tcfh2003/Proiect_CEF2/P1_2024_434C_Fratu-Halunga_Theodor-Corneliu_GST_N22_LTspice/Layout/Layout.jpg

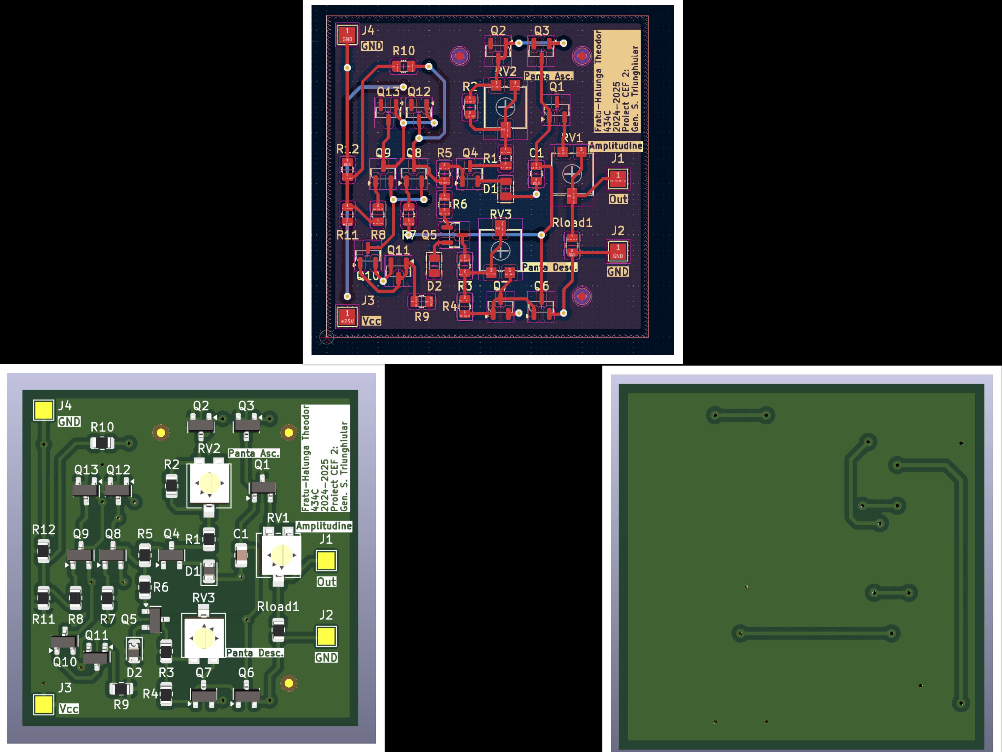
P1_2024_434C_Fratu-Halunga_Theodor-Corneliu_GST_N22_LTspice/Layout/Layout.jpg
