tcfh2003/Proiect_CEF2/P1_2024_434C_Fratu-Halunga_Theodor-Corneliu_GST_N22_LTspice/Schematics/Schematic_ProiectCEF2_KiCAD.jpg

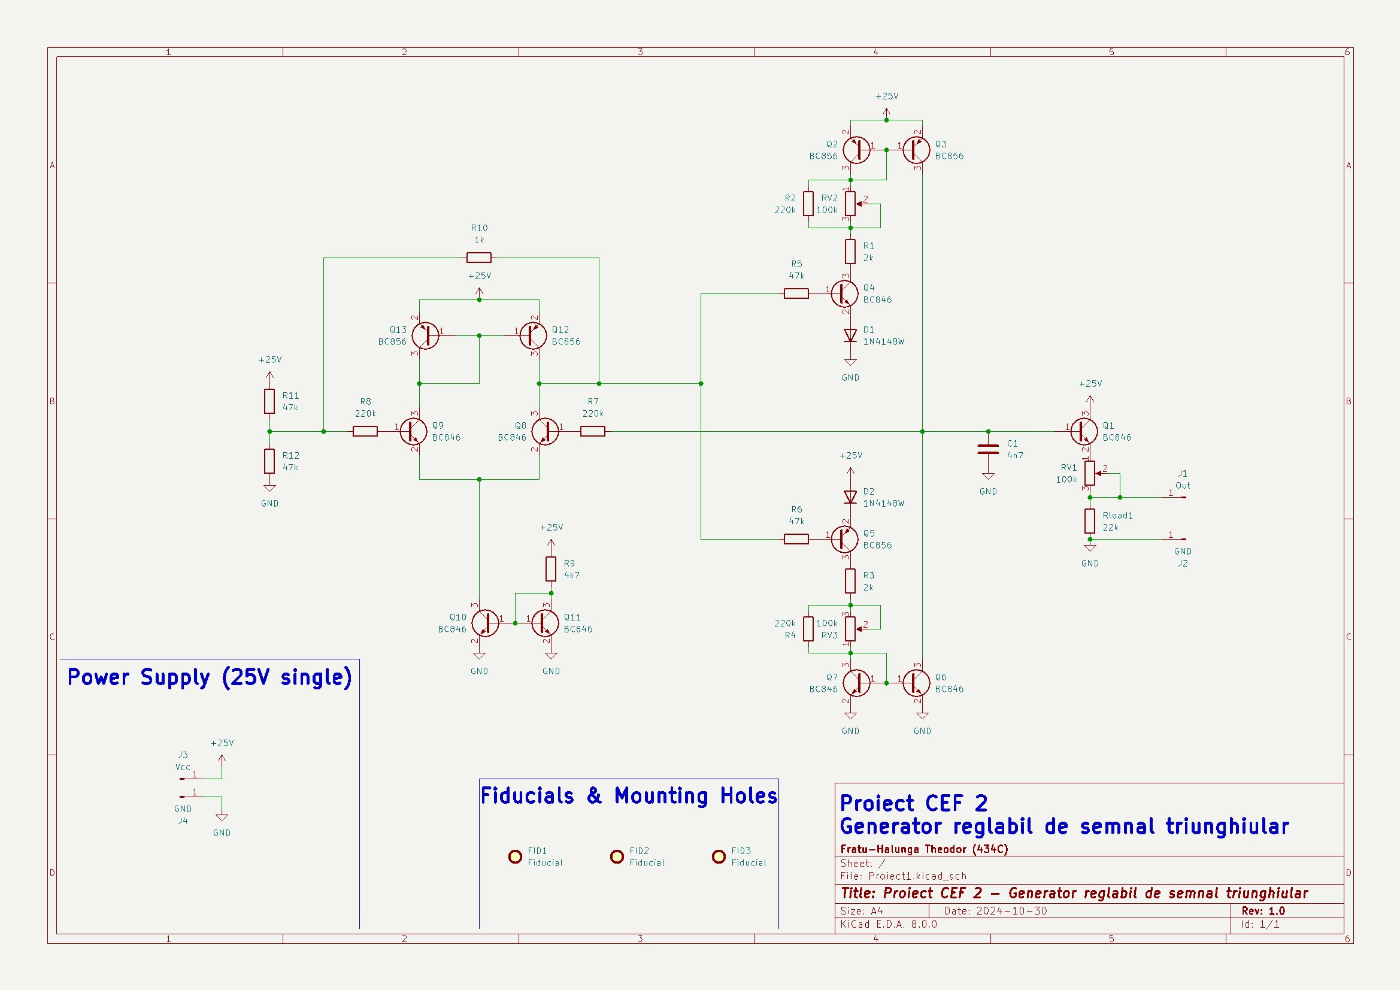
P1_2024_434C_Fratu-Halunga_Theodor-Corneliu_GST_N22_LTspice/Schematics/Schematic_ProiectCEF2_KiCAD.jpg
