tcfh2003/Proiect_CEF2/PCB_project/Proiect1/Gerbers/Proiect1-drl_map.dxf

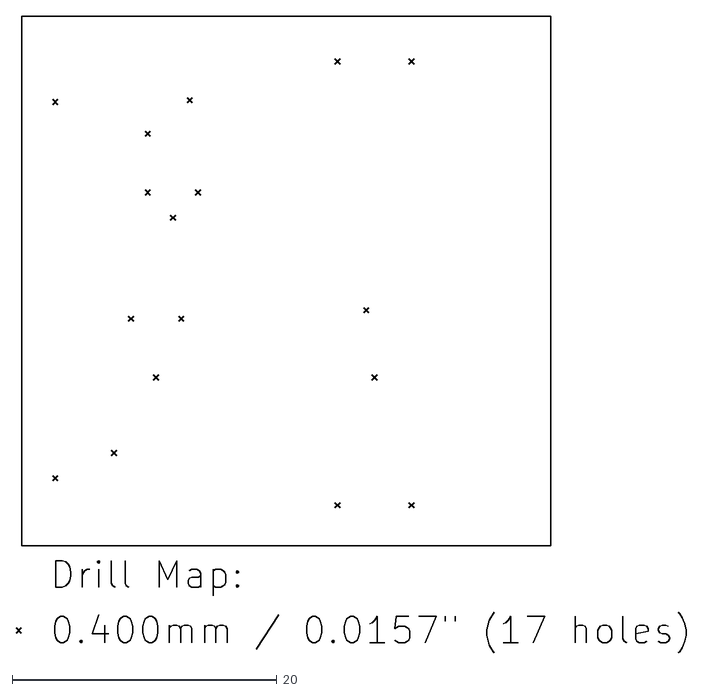
[picture p19: CAD file, 2024-12-08]
PCB_project/Proiect1/Gerbers/Proiect1-drl_map.dxf
50.6 x 48.1
