tcfh2003/Proiect_CEF2/SPICE_simulations/Proiect1_v5.asc

C3: cap; 4.7n
D1: diode; 1N4148
D2: diode; 1N4148
Q1: npn; BC846B
Q2: npn; BC846B
Q3: pnp; BC856B
Q4: pnp; BC856B
Q5: pnp; BC856B
Q6: npn; BC846B
Q7: npn; BC846B
Q8: pnp; BC856B
Q9: pnp; BC856B
Q10: npn; BC846B
Q11: npn; BC846B
Q12: npn; BC846B
Q13: npn; BC846B
R1: res; 5k
R2: res; 50k
R3: res; 50k
R4: res; 1k
R5: res; 64k
R6: res; 50k
R7: res; 50k
R8: res; 64k
R9: res; 500
R10: res; 220k
R11: res; 220k
Rload: res; 22k
V1: voltage; 25
Named nets: 0, Vcc, Vout
.tran 0 2.5m 1u uic
R_ctrl+ = R_ctrl- = 60k       =>    f = 2.32 kHz
R_ctrl+ = R_ctrl- = 2k         =>    f = 42 kHz
R9 = 500   =>   A = 11V
R9 = 90k   =>   A = 2.2V
.temp 0 25 50 70
.inc "C:\\Users\\TCFH2003\\Documents\\LTspice\\PSPICE_Models\\bc846b.lib"
.inc "C:\\Users\\TCFH2003\\Documents\\LTspice\\PSPICE_Models\\bc856b.lib"
R_ctrl+ = R_ctrl- = 64k       =>    f = 2.22 kHz
R_ctrl+ = R_ctrl- = 1.86k    =>    f = 44 kHz
R4 = 2k || 2k
R_ctrl+ = R_ctrl- = 2k + 220k || (0...100k)
