tcfh2003/Proiect_CEF2/SPICE_simulations/hysteresis_comparator.asc

M1: nmos; BS170
M2: nmos; BS170
M3: nmos; BS170
M4: nmos; BS170
M5: pmos; BS250P
M6: pmos; BS250P
Q1: npn; BC337-25
Q2: npn; BC337-25
Q3: pnp; BC327-25
Q4: pnp; BC327-25
Q5: npn; BC337-25
Q6: npn; BC337-25
R1: res; 2k
R2: res; 100k
R3: res; 1k
R4: res; 10k
R5: res; 10k
R6: res; 50k
R7: res; 50k
R8: res; 1k
R9: res; 5k
R10: res; 10k
R11: res; 2k
R12: res; 10k
R13: res; 10k
R14: res; 1k
U2: OP292
V1: voltage; 12
V2: voltage; SINE(6 6 1k)
V3: voltage; SINE(6 6 1k)
V4: voltage; SINE(6 6 1k)
Named nets: 0, Vcc, Vout, Vin+, Vin-, Vo, Vin_p, Vin_n
.tran 5m
.inc opamp.sub
.inc "C:\\Users\\TCFH2003\\Documents\\LTspice\\PSPICE_Models\\BS170.lib"
.inc "C:\\Users\\TCFH2003\\Documents\\LTspice\\PSPICE_Models\\BS250P.lib"
