tcfh2003/Proiect_CEF2/SPICE_simulations/Proiect1_v2_Integrator.asc

C1: cap; 10n
C2: cap; 10n
C3: cap; 100n
C4: cap; 10µ
C6: cap; 50n
C7: cap; 10µ
D1: diode; 1N4148
D2: diode; 1N4148
D3: diode; 1N4148
D4: diode; 1N4148
Q1: npn; BC337-25
Q2: npn; BC337-25
Q3: npn; BC337-25
Q4: npn; BC337-25
Q5: npn; BC337-25
Q6: npn; BC337-25
Q7: npn; BC337-25
R1: res; 10k
R3: res; 1k
R4: res; 1k
R5: res; 5k
R6: res; 5k
R7: res; 200k
R8: res; 20k
R9: res; 5k
R10: res; 2k
R11: res; 350
R13: res; 100k
Rload: res; 22k
V1: voltage; 30
Named nets: Vcc, 0, V_square, V_integrated, Vout
.tran 0 20m 19.5m uic
R11 = 80 => A = 10V
R11 = 160 => A = 5.2V
R11 = 400 => A = 2.5V
