tcfh2003/Proiect_CEF2/SPICE_simulations/Draft1.asc

C1: cap; 100n
R1: res; 1k
U1: LT1001
V1: voltage; 9
V2: voltage; 9
V3: voltage
Named nets: Vcc, Vee, 0, Vout
