tcfh2003/Proiect_CEF2/SPICE_simulations/simple_opamp.asc

C1: cap; 10p
M1: nmos; BS170
M2: nmos; BS170
M3: nmos; BS170
M4: nmos; BS170
M5: pmos; BS250P
M6: pmos; BS250P
M7: pmos; BS250P
M8: nmos; BS170
R1: res; 5k
R2: res; 5k
R3: res; 5k
R4: res; 10k
V1: voltage; 25
V2: voltage; SINE(10 10u 1k); AC 1
V3: voltage; SINE(10 0); AC 0
Named nets: 0, Vdd, In_n, In_p, Vout
.inc "C:\\Users\\TCFH2003\\Documents\\LTspice\\PSPICE_Models\\BS170.lib"
.inc "C:\\Users\\TCFH2003\\Documents\\LTspice\\PSPICE_Models\\BS250P.lib"
.tran 5m
.ac dec 10 10 1MEG
