tcfh2003/Proiect_CEF2/PCB_project/Proiect1/Proiect1.kicad_pcb

## KiCad design PCB_project/Proiect1/Proiect1.kicad_pcb (2024-12-08)

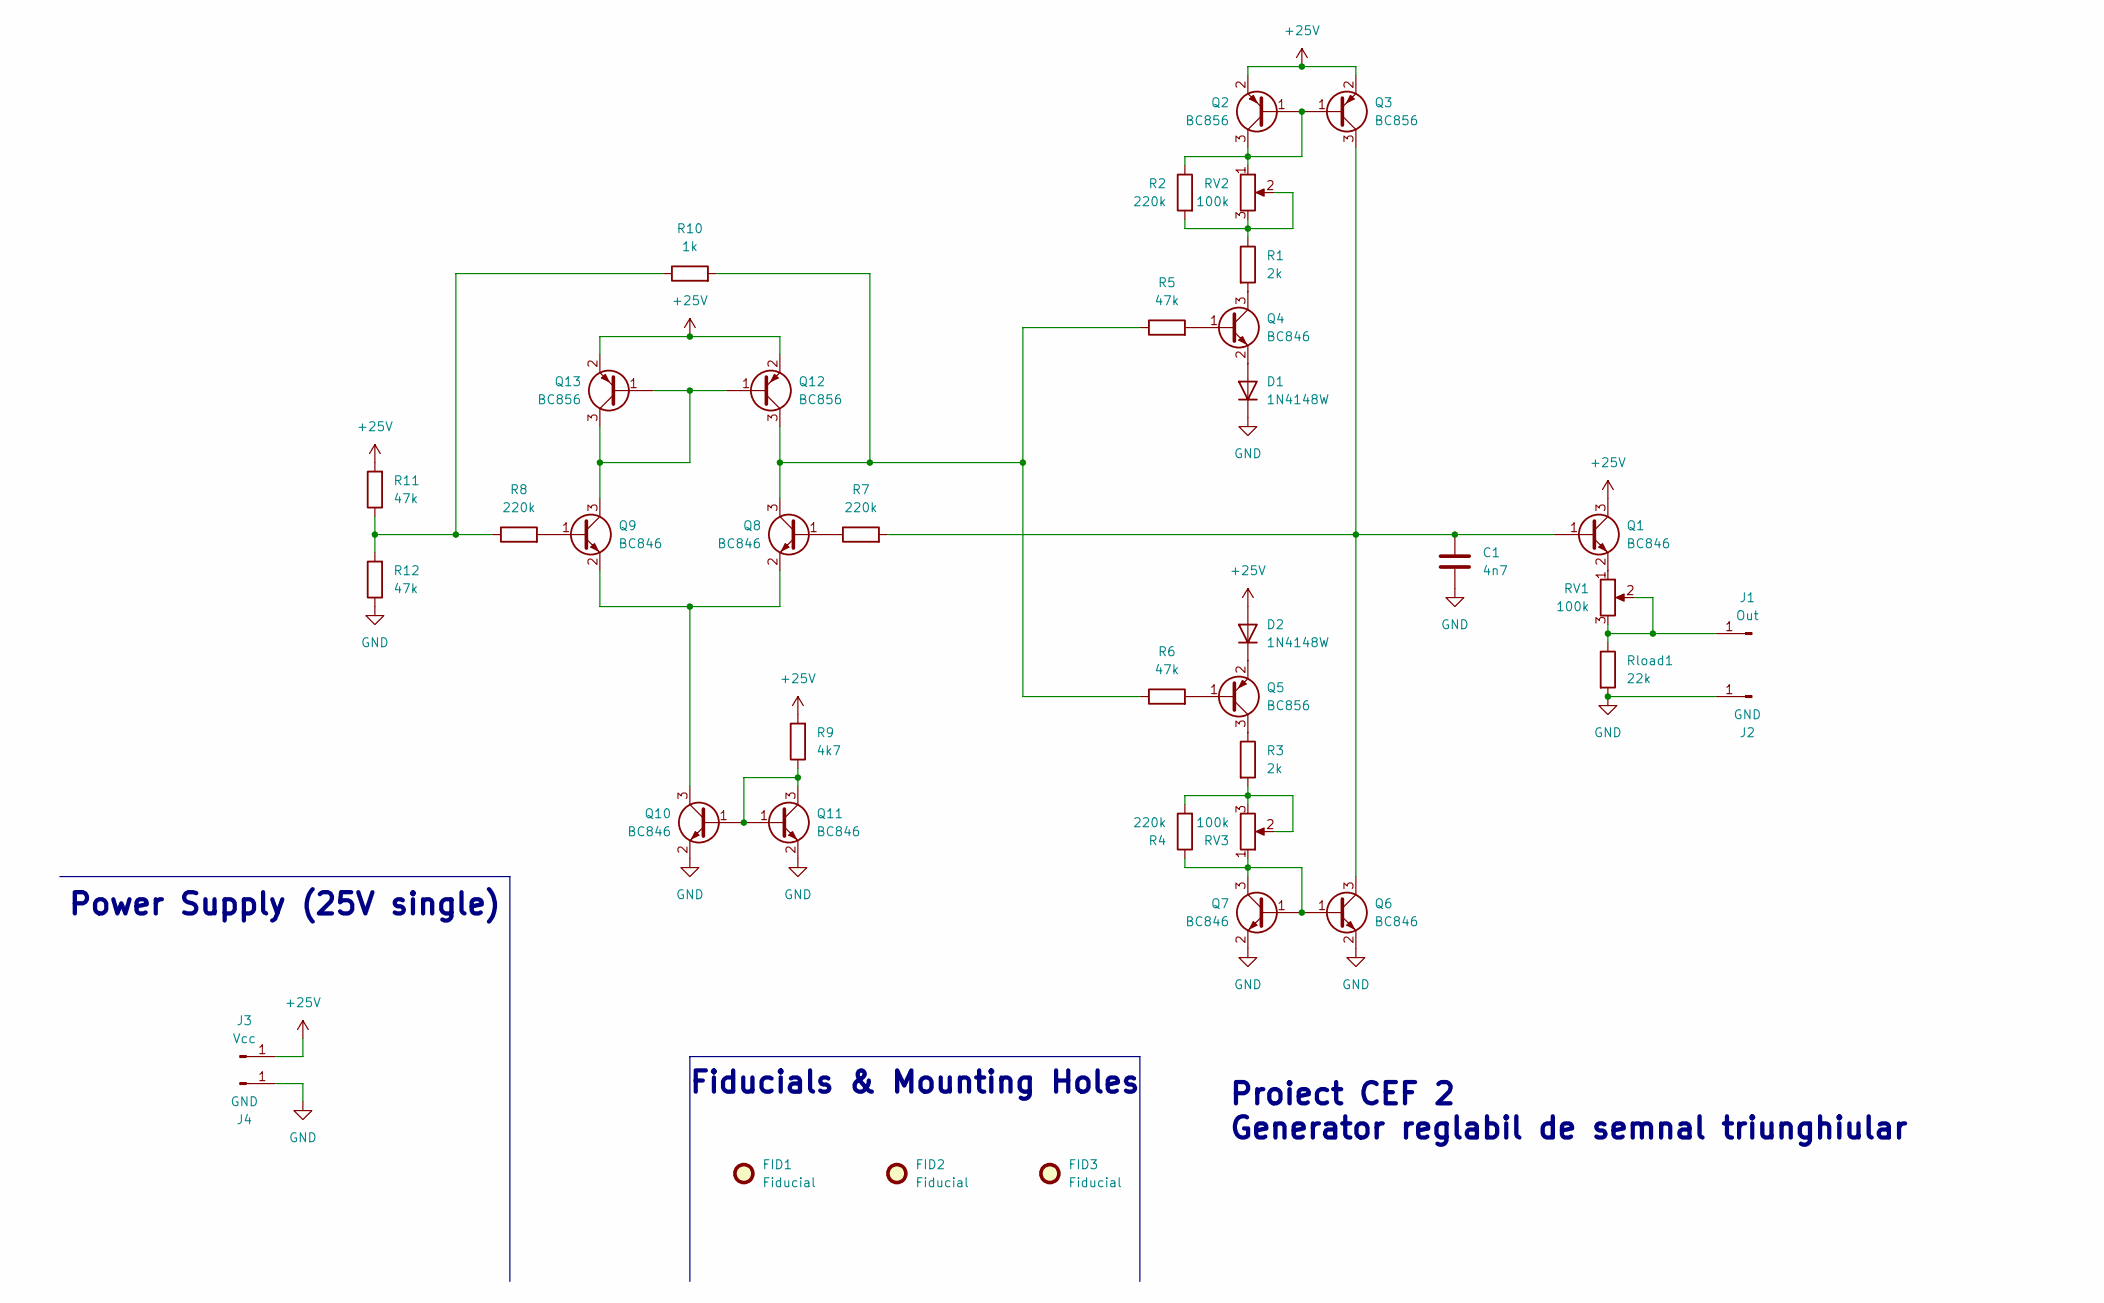
[picture p20: schematic Proiect1.kicad_sch, Proiect CEF 2 - Generator reglabil de semnal triunghiular]

Parts:
C1: 4n7; C_0805_2012Metric
D1, D2: 1N4148W; D_0805_2012Metric
FID1, FID2, FID3: Fiducial; Fiducial_1mm_Mask2mm
J1: Out; TestPoint_Pad_2.0x2.0mm
J2, J4: GND; TestPoint_Pad_2.0x2.0mm
J3: Vcc; TestPoint_Pad_2.0x2.0mm
Q1, Q4, Q6, Q7, Q8, Q9, Q10, Q11: BC846; SOT-23
Q2, Q3, Q5, Q12, Q13: BC856; SOT-23
R1, R3: 2k; R_0805_2012Metric
R2, R4, R7, R8: 220k; R_0805_2012Metric
R5, R6, R11, R12: 47k; R_0805_2012Metric
R9: 4k7; R_0805_2012Metric
R10: 1k; R_0805_2012Metric
RV1, RV2, RV3: 100k; Potentiometer_Vishay_TS53YL_Vertical
Rload1: 22k; R_0805_2012Metric

Connections:
+25V: D2.2 (A), J3.1, Q1.3 (C), Q2.2 (E), Q3.2 (E), Q12.2 (E), Q13.2 (E), R9.2, R11.2
GND: C1.2, D1.1 (K), J2.1, J4.1, Q6.2 (E), Q7.2 (E), Q10.2 (E), Q11.2 (E), R12.1, Rload1.2
unnamed: D1.2 (A), Q4.2 (E)
unnamed: D2.1 (K), Q5.2 (E)
unnamed: J1.1, RV1.2, RV1.3, Rload1.1
unnamed: C1.1, Q1.1 (B), Q3.3 (C), Q6.3 (C), R7.2
unnamed: Q1.2 (E), RV1.1
unnamed: Q2.1 (B), Q2.3 (C), Q3.1 (B), R2.1, RV2.1
unnamed: Q4.1 (B), R5.2
unnamed: Q4.3 (C), R1.2
unnamed: Q5.1 (B), R6.2
unnamed: Q5.3 (C), R3.1
unnamed: Q6.1 (B), Q7.1 (B), Q7.3 (C), R4.1, RV3.1
unnamed: Q8.1 (B), R7.1
unnamed: Q9.1 (B), R8.2
unnamed: Q10.1 (B), Q11.1 (B), Q11.3 (C), R9.1
unnamed: Q8.2 (E), Q9.2 (E), Q10.3 (C)
unnamed: Q9.3 (C), Q12.1 (B), Q13.1 (B), Q13.3 (C)
unnamed: Q8.3 (C), Q12.3 (C), R5.1, R6.1, R10.2
unnamed: R1.1, R2.2, RV2.2, RV2.3
unnamed: R3.2, R4.2, RV3.2, RV3.3
unnamed: R8.1, R10.1, R11.1, R12.2

Notes on the sheet:
Power Supply (25V single)
Proiect CEF 2 Generator reglabil de semnal triunghiular
Fiducials & Mounting Holes

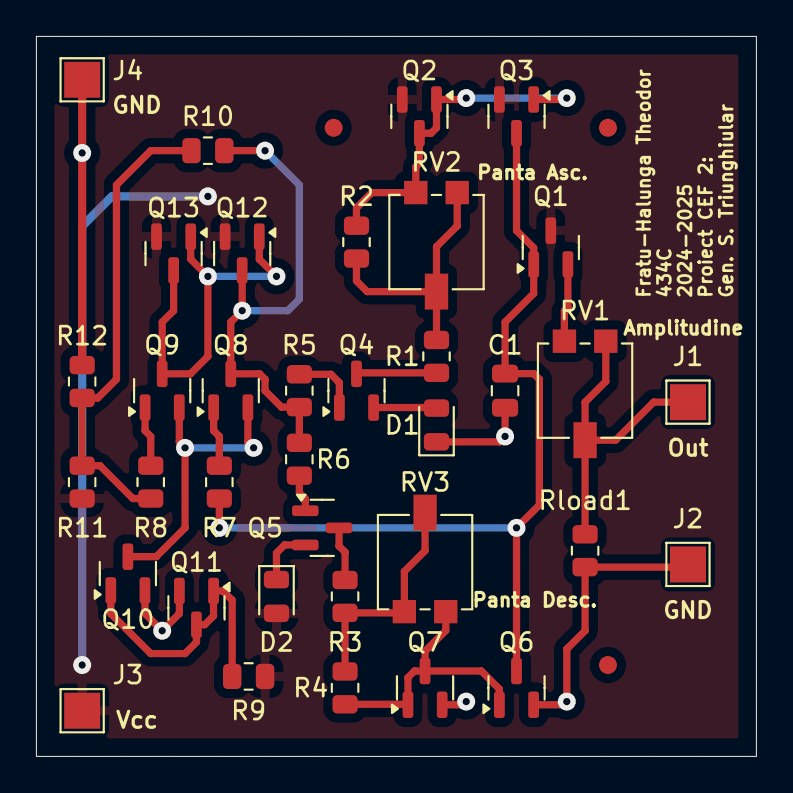
[picture p21: board Proiect1.kicad_pcb from above]

Board: 2 copper layers, 40.0 x 40.0 mm, 39 parts (0 on the bottom side), 22 nets.
