tcfh2003/Proiect_CEF2/(commit log)

2024-10-12 First commit
    So far tried to use a square wave oscillator with an integrator after it and two current sources going into a capacitor, which toggle on and off alternatingly via a Schmitt trigger / Hysteresis Comparator
2024-10-12 MOSFET Schmitt Trigger works better than BJT one
2024-10-12 Proiect1_v3 now works via a Schmitt Trigger / Hysteresis Comparator made from MOSFETS
2024-10-12 As far as I can see, project is done
    Added a final common drain source follower. Amplitude control is done by a voltage divider, probably using a 100k potentiometer. Frequency and simmetry control will be done using two 25k potentiometers. Technology used is MOSFET, specifically BS170 nMOS and BS250 pMOS. Supply voltage is 25V and median power consumption is 250mW.
2024-10-12 Changed value of capacitor from 10nF to 2nF
    Did so in order to lower the current, therefore lowering the maximum and average power dissipation of the current source mosfets from 200mW to about 50mW, keeping well within the 330mW maximum power rating of SOT-23 BS-170 and BS-250 MOSFETS.
    Another added benefit of the previous addition is that now I can use 100kOhm potentiometers for the current sources as well, meaning that there are fewer different parts to get.
    Also added temperature analysis, the only thing that seems to happen is that as temperature increases, the frequency of oscillation also increases slightly. Eyeballing it, I'd say it's less than a 10% deviation across the entire temp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
2024-10-18 Created a file to test op-amp circuits
    Might want to make the comparator in my triangle oscillator circuit a bit more like a real op-amp in the future.
2024-10-19 Created the PCB for the project
    [Proiect1.kicad_pcb, Proiect1.kicad_sch]
2024-10-29 Changed the circuit so that it's BJT based
    Using BC846B and BC856B BJT transistors. Also had to add some resistors and some 1N4148 diodes. Will see what else changed later.
2024-10-29 Started new PCB
    [Proiect1.kicad_pcb, Proiect1.kicad_sch]
2024-10-29 Finished PCB
    [Proiect1.kicad_pcb]
2024-10-31 Added 3d models to potentiometers
    [Proiect1.kicad_pcb]
2024-11-13 Updated PCB to conform with Manufacturing Requirements
    Changed trace widths form 20 mils to 16 mils. Changed via sizes from 0.5mm/1mm to 0.4mm/1mm. Changed edge clearance from 0.5mm to 1mm. Changed trace clearance from 5? mils to 14 mils. Added 3 fiducials of size 1mm/2mm.
    Still need to see what is up with that MECHANIC layer. Need to generate a mechanical drawing for the board edge, a drill drawing, a drill table and a drill legend as well as a layer stackup (technically KiCad already did this for me automatically but I don't know if this needs to be included in this MECHANIC layer or not)
    [Proiect1.kicad_pcb, Proiect1.kicad_sch]
2024-11-29 Changed jumpers from THT to SMD
    [Proiect1.kicad_pcb, Proiect1.kicad_sch]
2024-11-29 Changed some of the power traces from 16 mil to 18 mil
    [Proiect1.kicad_pcb]
2024-11-29 Changed reference designators J3, J4 to J2, J3
    [Proiect1.kicad_pcb, Proiect1.kicad_sch]
2024-11-29 Added Drill Table and simple stackup table
    [Proiect1-drl_map.dxf, Proiect1.kicad_pcb, Proiect1.kicad_sch]
2024-12-08 Changed footprints of header pins for Power and Output
    [Proiect1-NPTH-drl_map.dxf, Proiect1-PTH-drl_map.dxf, Proiect1-drl_map.dxf, Proiect1.kicad_pcb, Proiect1.kicad_sch]
2024-12-08 Changed Drill Map and Drill Table to fit current layout
    Also added a .gitignore file. A bit late for this right now, but better late than never. Maybe one day I'll actually learn to include this at the start of projects instead of the end of them :/
    [Proiect1-NPTH-drl_map.dxf, Proiect1-PTH-drl_map.dxf, Proiect1-drl_map.dxf, Proiect1.kicad_pcb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]
2024-12-08 Delete PCB_project/Proiect1/Proiect1-backups directory
    This doesn't need to stay here on GitHub. If I had actually remembered to add that .gitignore file at the start, these wouldn't even be here.
2024-12-08 Fixed some alignment issues
    [Proiect1.kicad_pcb]
2024-12-08 Created Gerber files
    Also moved the stackup and the drill map on the same layer, because apparently KiCad can't export multiple layers in the same Gerber file.
    [Proiect1.kicad_pcb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]
2024-12-13 Added final archive of project
    Archive contains Gerber Files, drawings of the KiCAD schematic, images of the PCB in KiCAD PCBView and KiCAD 3DView, Block Diagram, Simulation Waveforms, LTspice simulation file and transistor library files, the entire KiCAD project in archived form and PCB Manufacturing Table that specifies which gerber file represents what layer.
    Will also need to add the Technical Documentation later on, in which I explain exactly how the circuit is supposed to function, how it's supposed to be supplied as well as collage all the aforementioned things.
    [Anexa_a1_Grupa_......xls, BOM_KiCAD_ProiectCEF2.csv, Proiect1.kicad_sch, Proiect1_BlockDiagram.kicad_pcb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]
2024-12-25 Completed documentation
    [Anexa_a1_Grupa_......xls]
